AlonSpinner/GarageDoor_with4Bar/Documentation/7Min.pptx

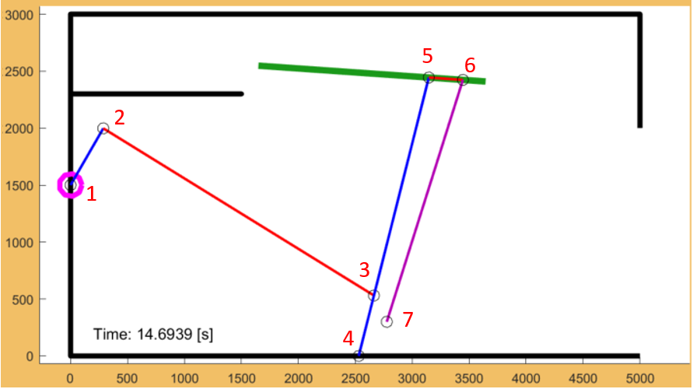
[picture p4: figure]
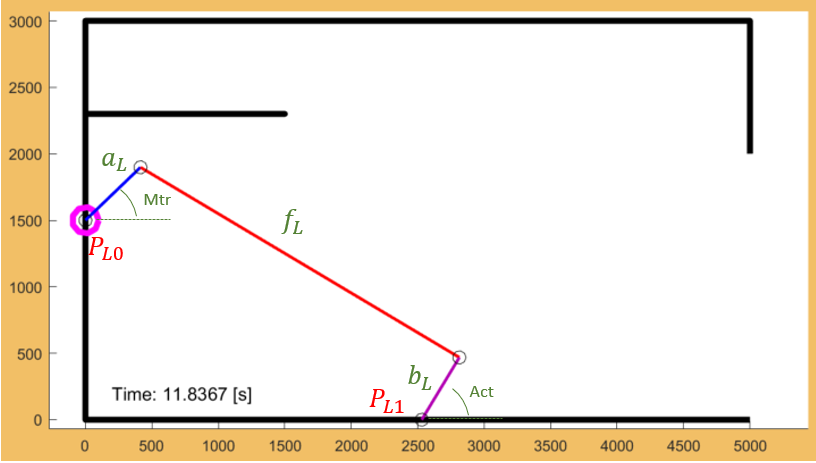
[picture p5: figure]
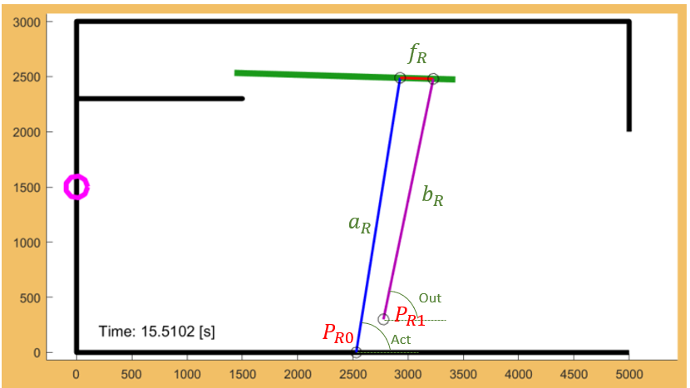
[picture p6: figure]

## Slide 2

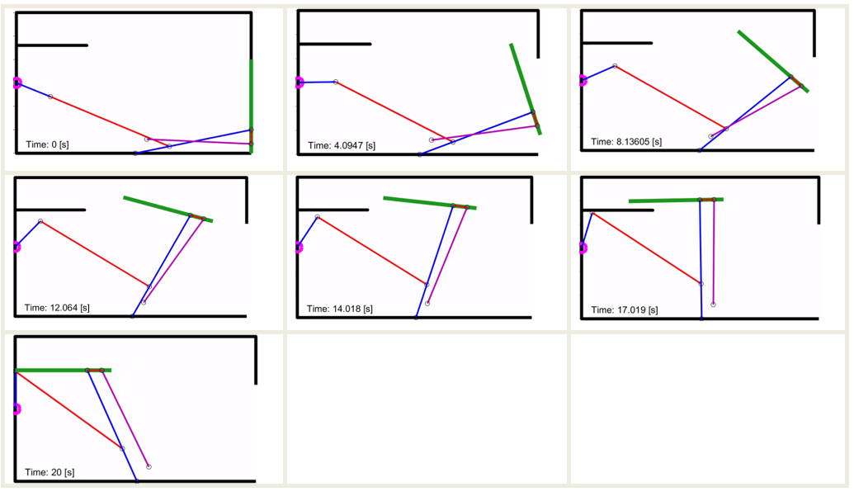
[picture p7: figure]

## Slide 3

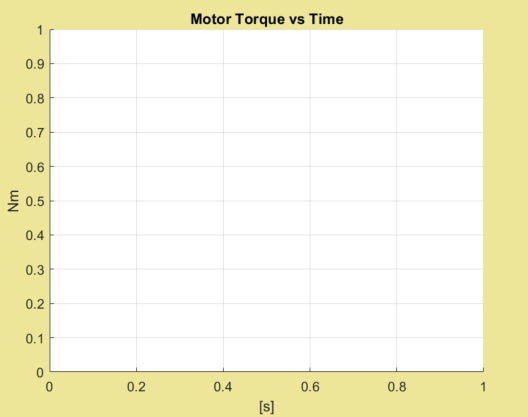
[picture p8: figure]

## Slide 4

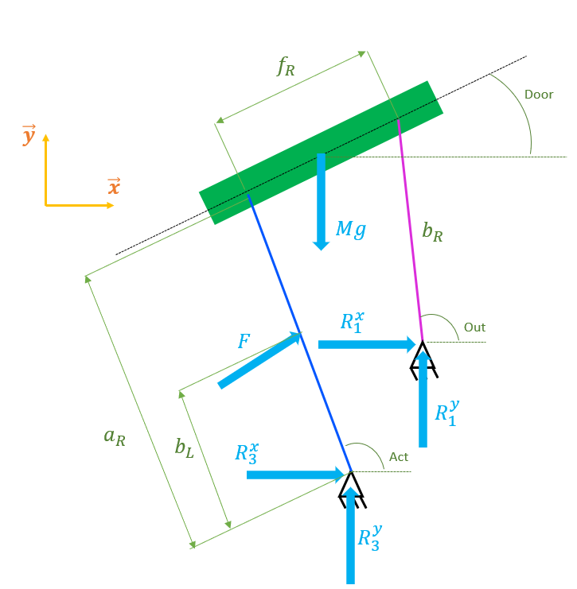
[picture p9: figure]
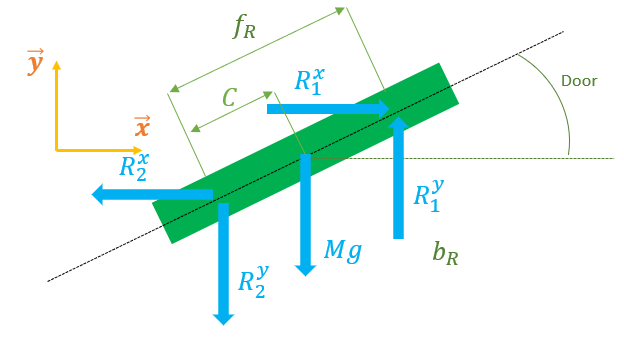
[picture p10: figure]
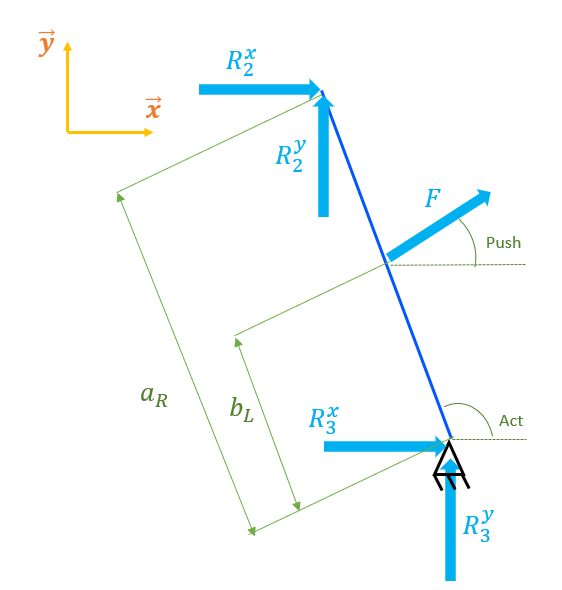
[picture p11: figure]
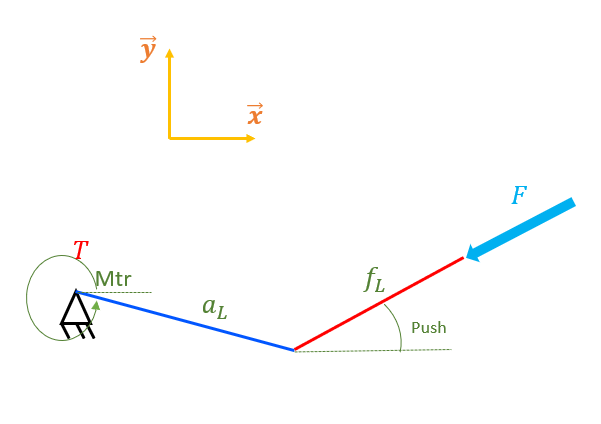
[picture p12: figure]

## Slide 5

סינטזה מכניזם שמאל
Freundestein

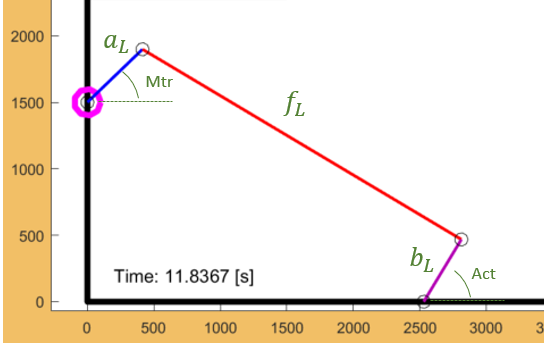
[picture p13: figure]

סינטזה מכניזם ימין
2 נק' דיוק לכל ציר

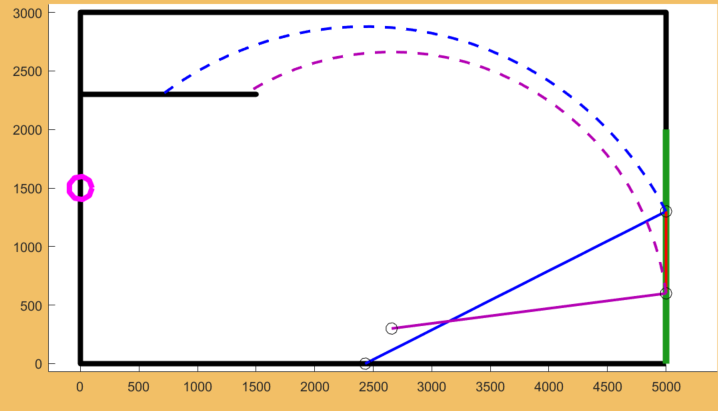
[picture p14: figure]
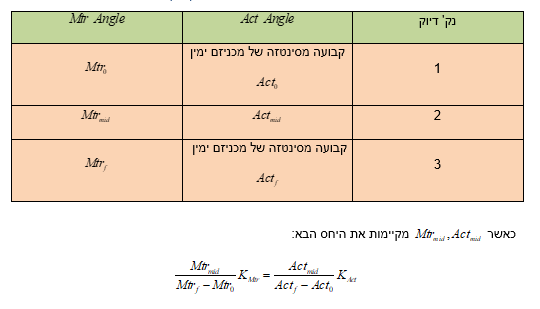
[picture p15: figure]
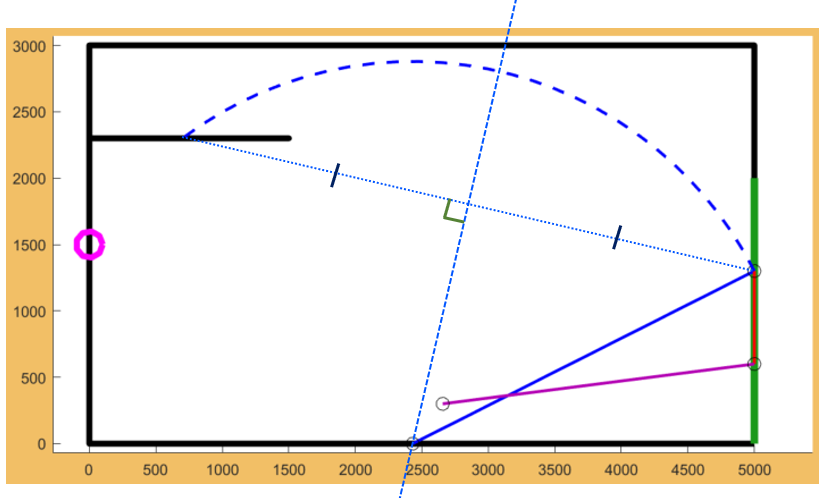
[picture p16: figure]

## Slide 6

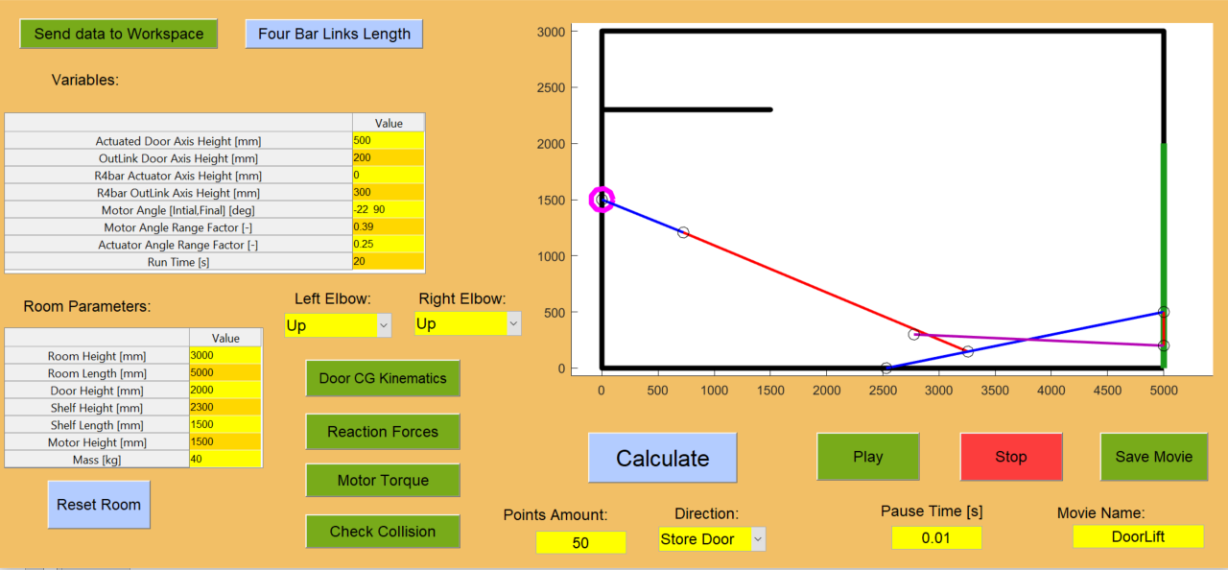
[picture p17: figure]

## Slide 7

נכנסו במדף. מנסים להוריד את הסמכים במנגנון ימין

כבר ממש טוב. אבל אפשר להוריד את הצירים של הדלת עוד.

טריקה של דלת
בסוף מסלול.
מנסים לקצר זרוע מניעה

מגדילים טווח זוויות ע"י שינוי כיוון

מומנטים גבוהים מידי נובעים מטריקה של דלת בסוף מסלול. עוברים לזוויות צד שני

מתרחקים מהנק' המתה. מקטינים ריאקציות, ומגדילים קצת מומנט, כדי להגיע לנק' המושלמת. מתחת ל-2500N רדיאלי

כיוון טוב. מנסים לשפר ע"י הורדה של הגובה בצירים של הדלת

## Slide 8

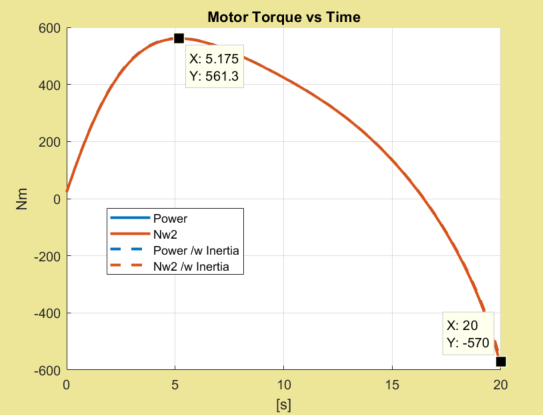
[picture p18: figure]
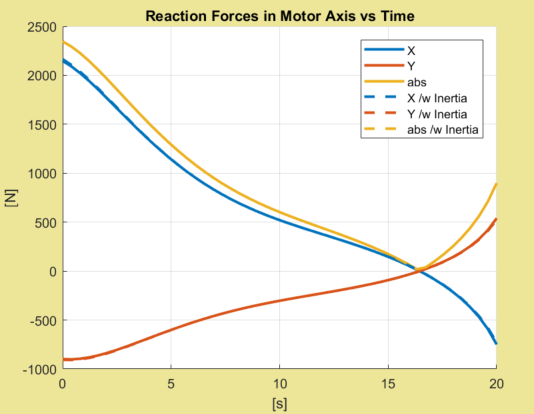
[picture p19: figure]

## Slide 9

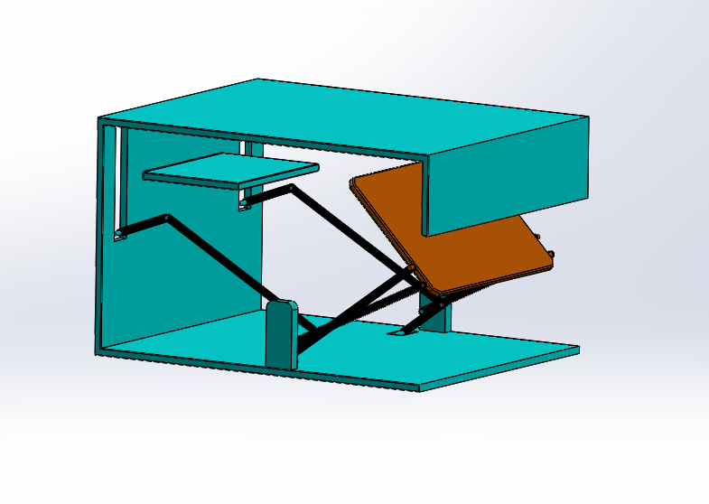
[picture p20: figure]
