AlonSpinner/GarageDoor_with4Bar/Documentation/Images.pptx

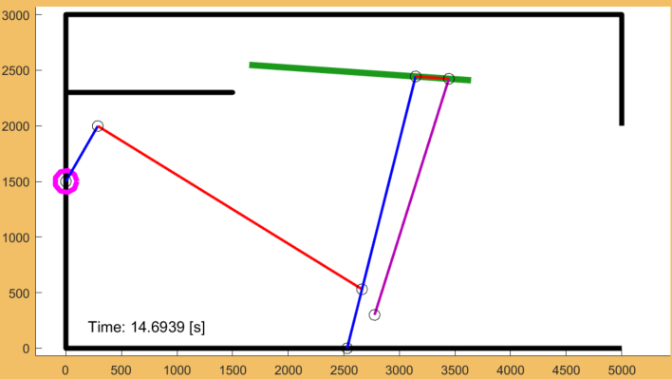
[picture p21: figure]

5

6

2

1

3

4

7

## Slide 2

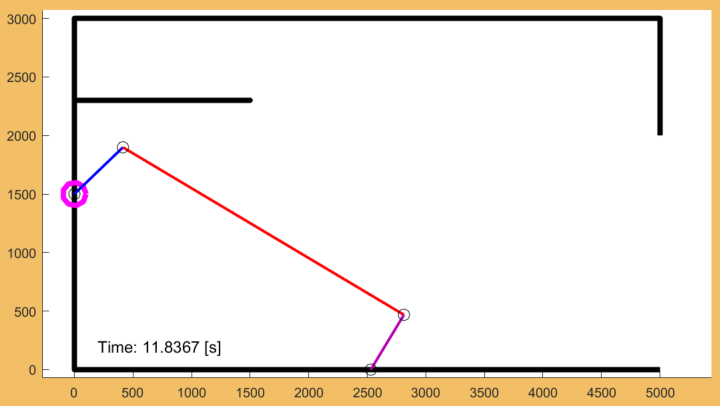
[picture p22: figure]

a_L

P_(L0)

Mtr

f_L

P_(L1)

Act

b_L

## Slide 3

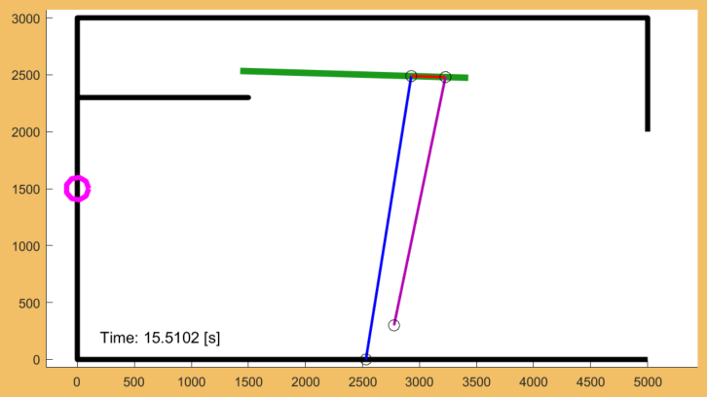
[picture p23: figure]

f_R

Actuator

b_R

a_R

Out

Act

P_(R1)

P_(R0)

## Slide 4


## Slide 5

## Slide 6

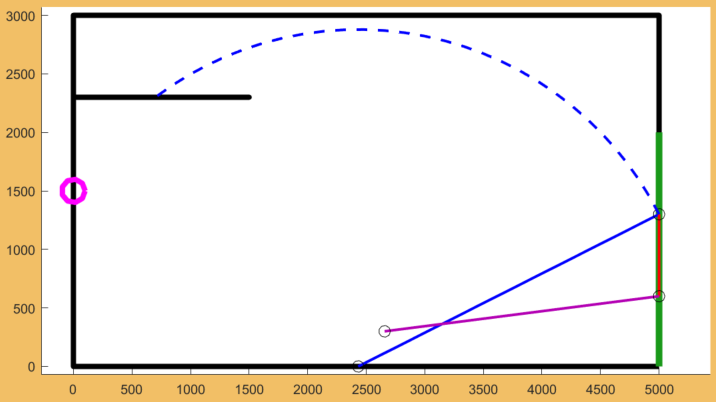
[picture p24: figure]

## Slide 7

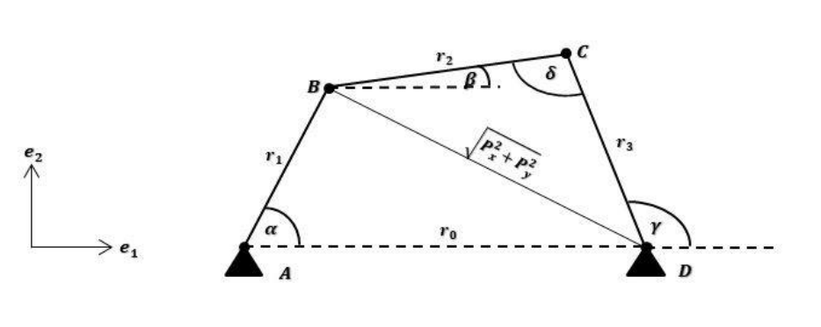
[picture p25: figure]

f

a

b

g

## Slide 8

f

a

e

b

g

## Slide 9

E_2

H_(door)

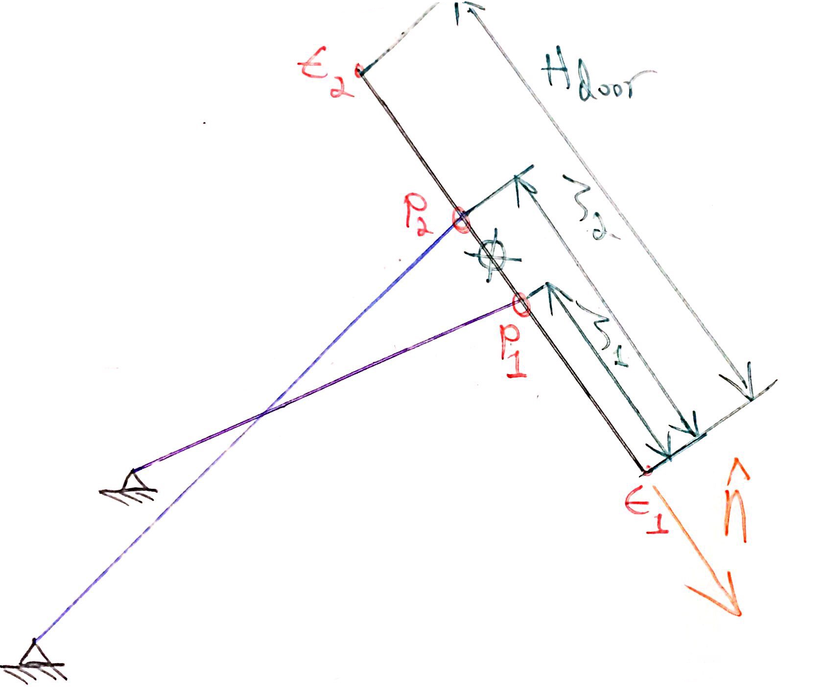
[picture p26: figure]

P_2

ξ_2

ξ_1

P_1

E_1

n

## Slide 10

θ

r

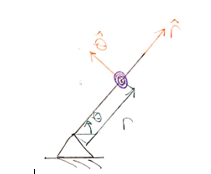
[picture p27: figure]

r

θ

## Slide 11

a

H_(door)

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
## Slide 12

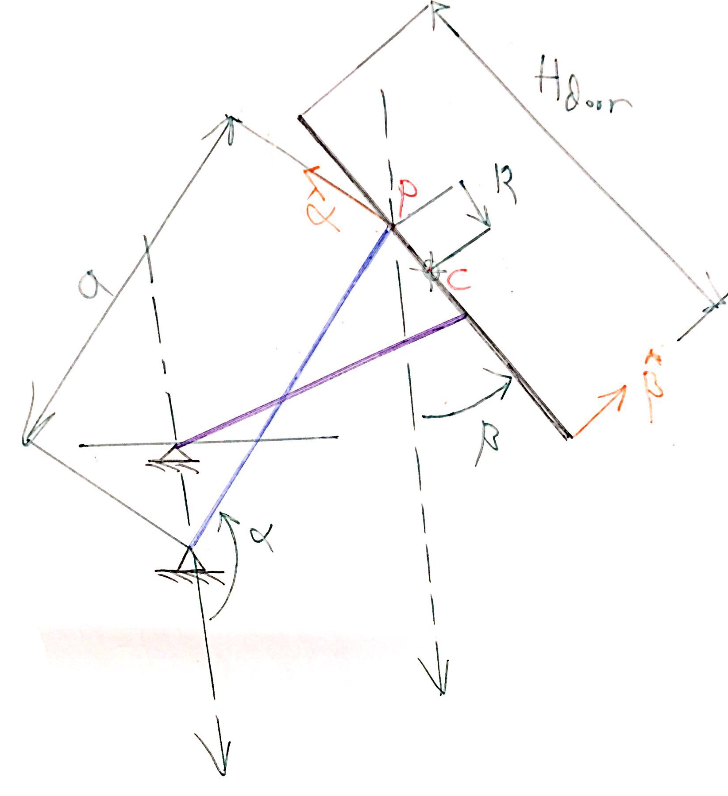
[picture p28: figure]

H_(door)

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
## Slide 13

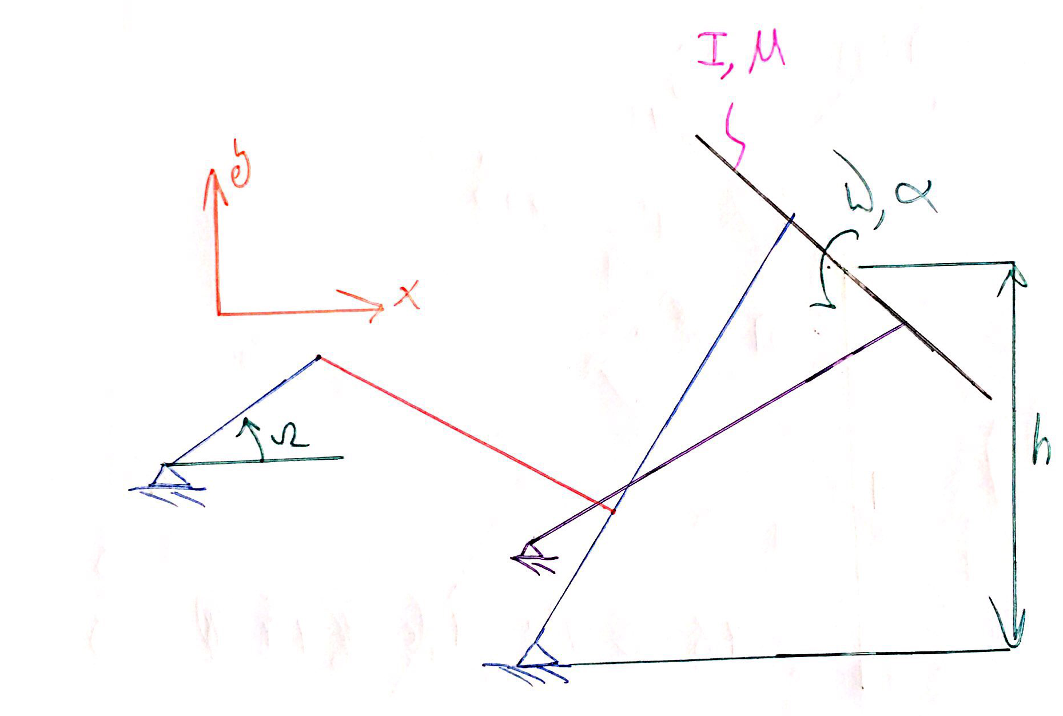
[picture p29: figure]

y

x

I,M

α, ω

Ω

h

β

## Slide 14

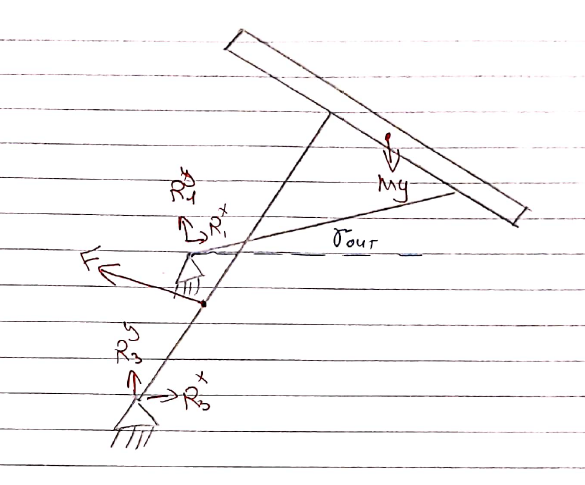
[picture p30: figure]

f_R

Door

y

x

Mg

b_R

F

R_1^x

Out

a_R

b_L

R_3^x

Act

R_1^y

R_3^y

## Slide 15

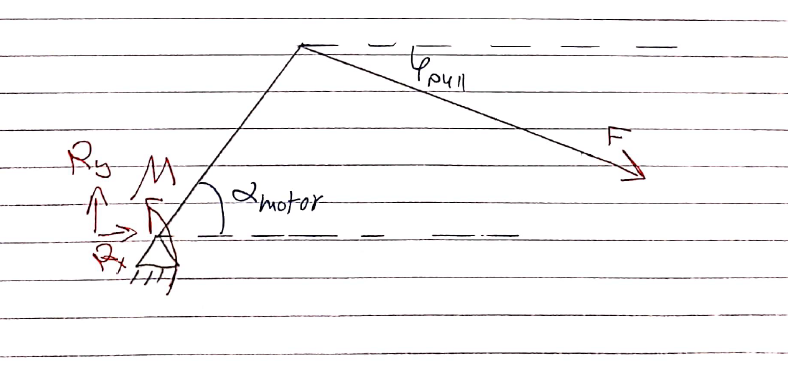
[picture p31: figure]

y

x

F

Mtr

T

Push

f_L

a_L

## Slide 16

f_R

y

C

R_1^x

Door

R_2^x

x

R_1^y

R_2^y

Mg

b_R

## Slide 17

y

R_2^x

x

R_2^y

Push

F

a_R

b_L

R_3^x

Act

R_3^y

## Slide 18

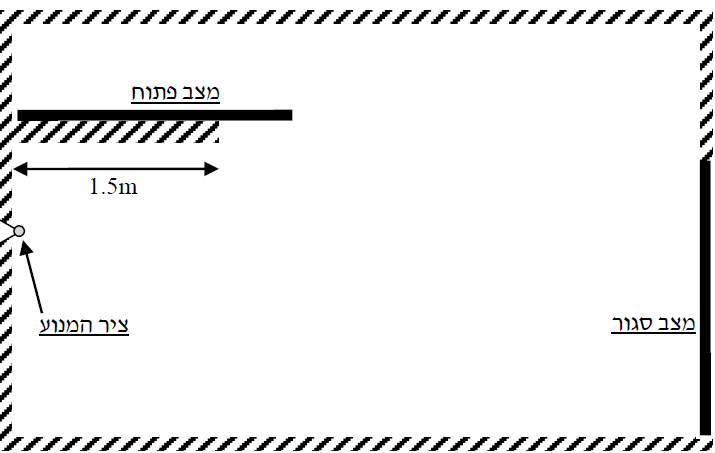
[picture p32: figure]
