AlonSpinner/GarageDoor_with4Bar/Solidworks/Room assembly.SLDASM

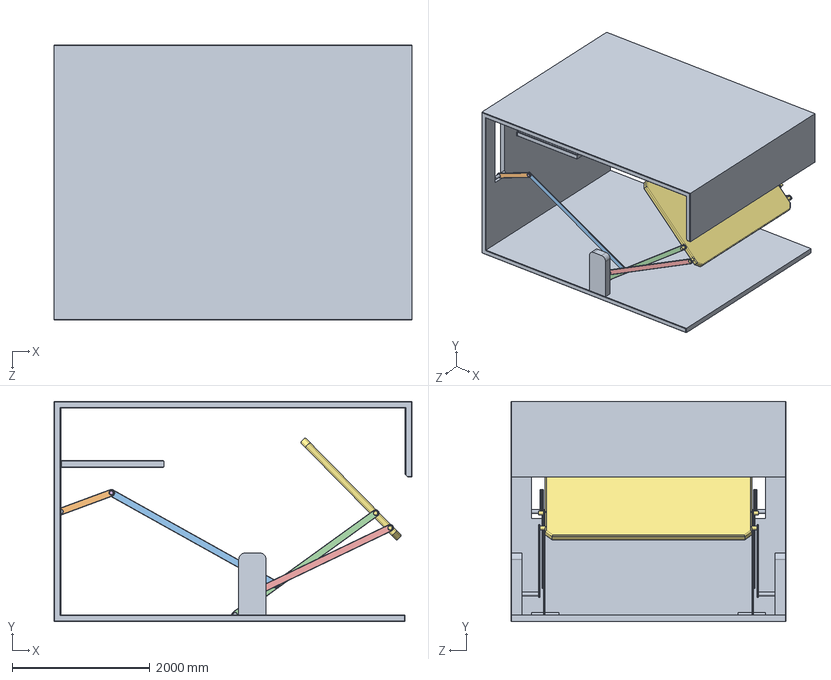
[picture p58: CAD file, 2021-06-20]
Solidworks/Room assembly.SLDASM
5200.0 x 3200.0 x 4000.0 mm
frame
motor a link x 2
motor f link x 2
actoator a link x 2
actoator b link x 2
pin x 4
door
