AlonSpinner/GarageDoor_with4Bar/Solidworks/actoator a link.SLDPRT

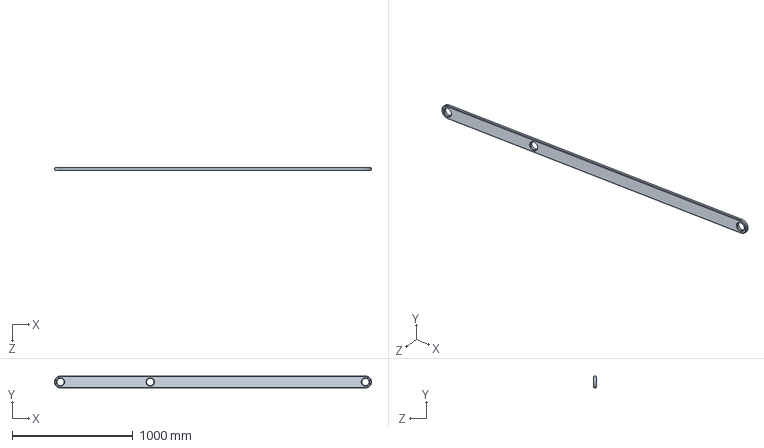
[picture p59: CAD file, 2021-06-20]
Solidworks/actoator a link.SLDPRT
2620.0 x 100.0 x 25.0 mm
