AlonSpinner/GarageDoor_with4Bar/Solidworks/actoator b link.SLDPRT

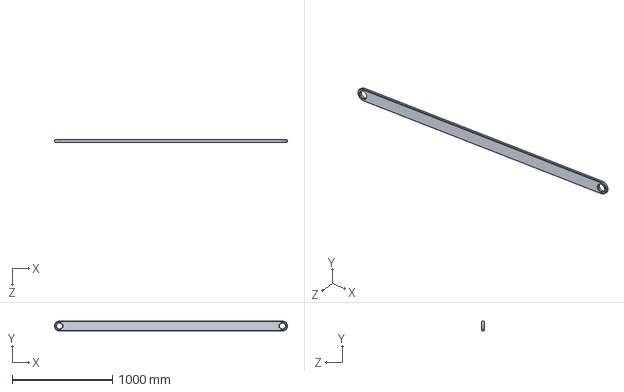
[picture p60: CAD file, 2021-06-20]
Solidworks/actoator b link.SLDPRT
2325.0 x 100.0 x 25.0 mm
