AlonSpinner/GarageDoor_with4Bar/Solidworks/frame.SLDPRT

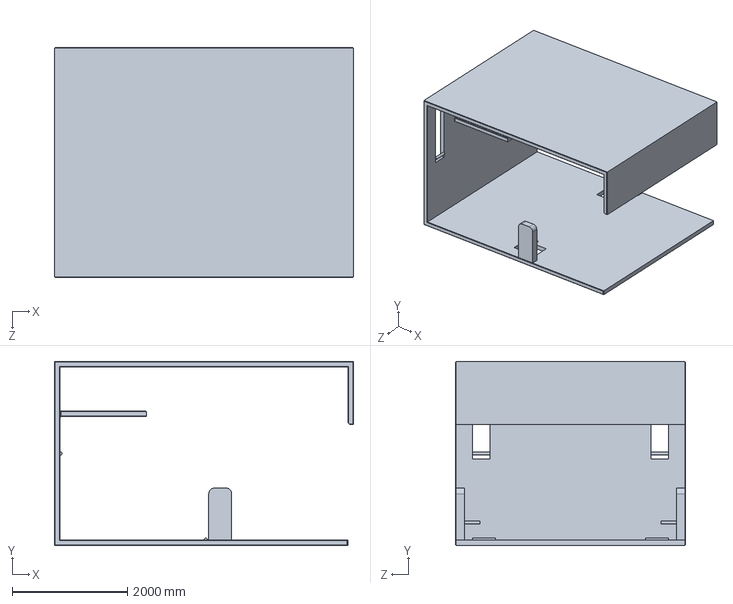
[picture p61: CAD file, 2021-06-20]
Solidworks/frame.SLDPRT
5200.0 x 3200.0 x 4000.0 mm
