AlonSpinner/GarageDoor_with4Bar/Solidworks/general link.SLDPRT

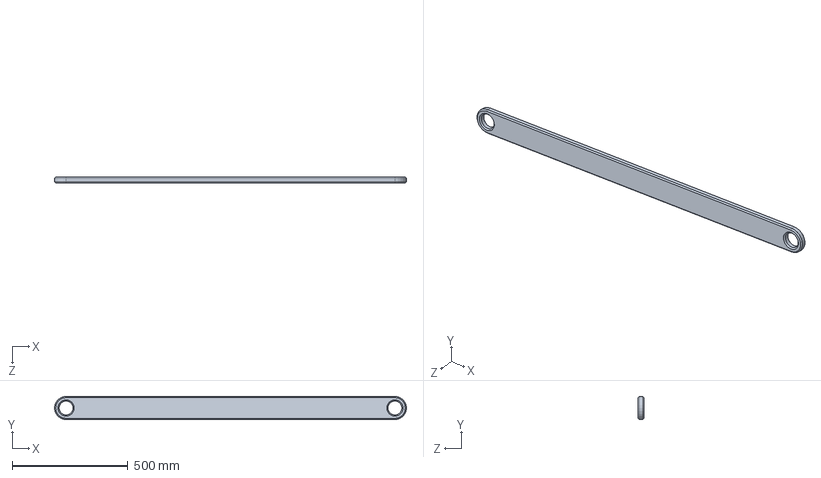
[picture p62: CAD file, 2021-06-20]
Solidworks/general link.SLDPRT
1520.0 x 100.0 x 25.0 mm
