AlonSpinner/GarageDoor_with4Bar/Solidworks/test.SLDPRT

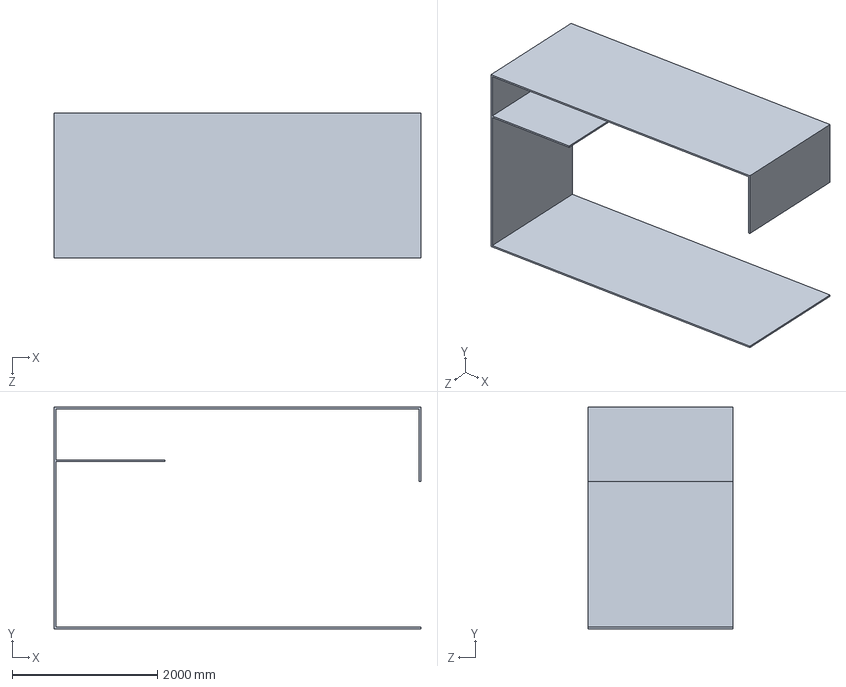
[picture p63: CAD file, 2021-06-20]
Solidworks/test.SLDPRT
5050.0 x 3050.0 x 2000.0 mm
