AlonSpinner/GarageDoor_with4Bar/Solidworks/motor b link.SLDPRT

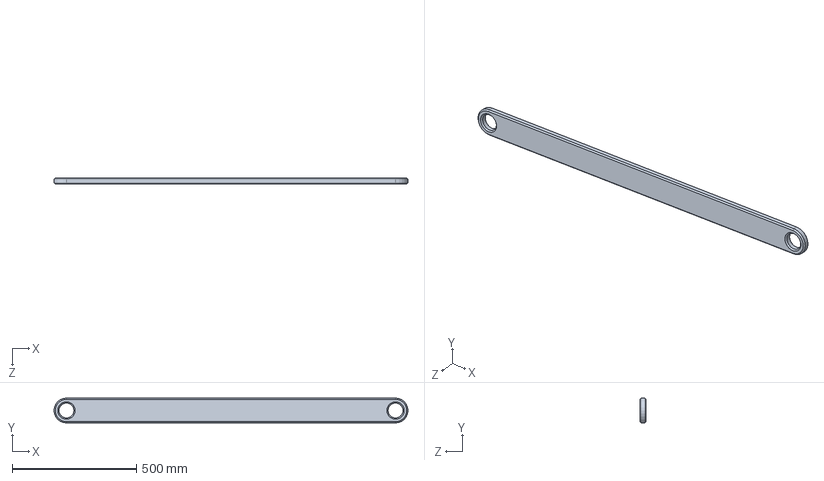
[picture p64: CAD file, 2021-06-20]
Solidworks/motor b link.SLDPRT
1425.0 x 100.0 x 25.0 mm
