AlonSpinner/GarageDoor_with4Bar/Solidworks/pin.SLDPRT

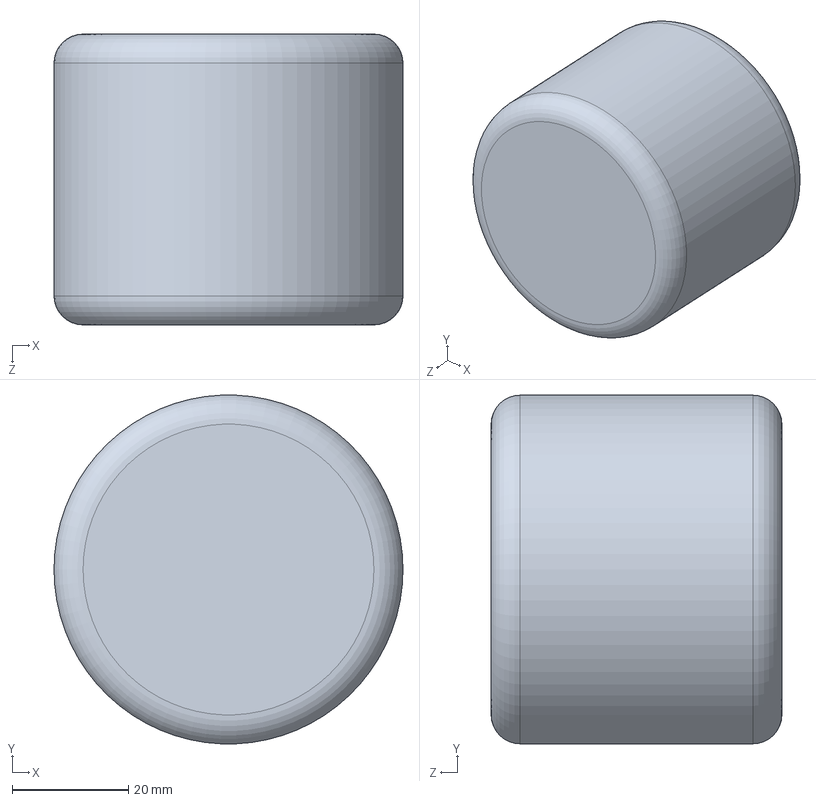
[picture p65: CAD file, 2021-06-20]
Solidworks/pin.SLDPRT
60.0 x 59.9 x 50.0 mm
