AlonSpinner/GarageDoor_with4Bar/Solidworks/motor f link.SLDPRT

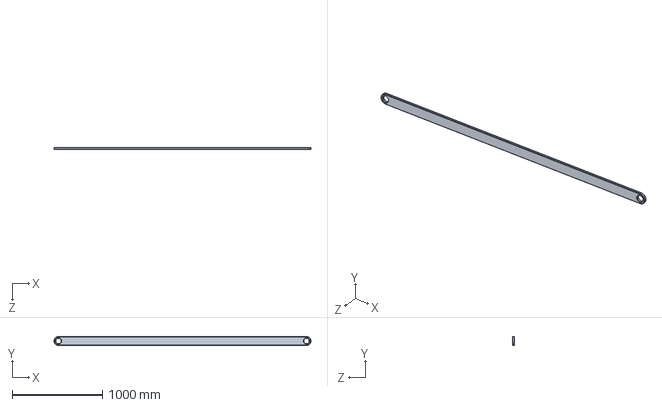
[picture p66: CAD file, 2021-06-20]
Solidworks/motor f link.SLDPRT
2845.0 x 100.0 x 25.0 mm
