AlonSpinner/GarageDoor_with4Bar/Solidworks/motor a2 link.SLDPRT

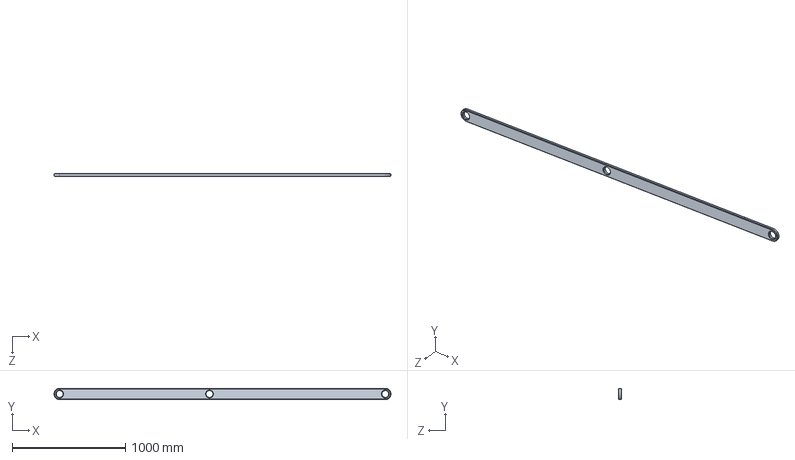
[picture p67: CAD file, 2021-06-20]
Solidworks/motor a2 link.SLDPRT
2980.0 x 100.0 x 25.0 mm
