AlonSpinner/GarageDoor_with4Bar/Solidworks/door.SLDPRT

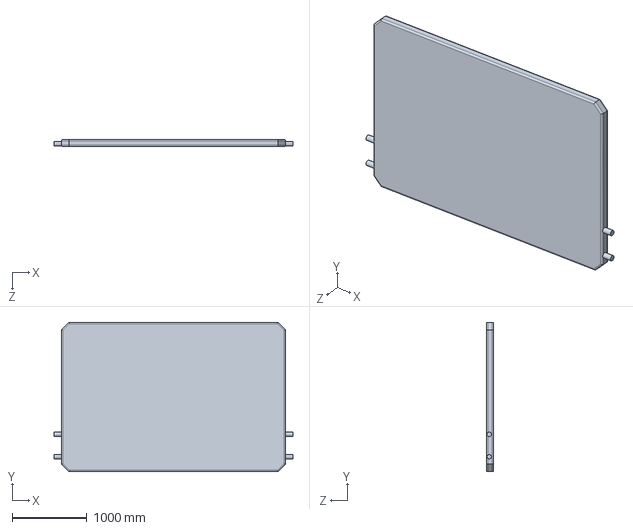
[picture p68: CAD file, 2021-06-20]
Solidworks/door.SLDPRT
3200.0 x 2000.0 x 100.0 mm
