AlonSpinner/GarageDoor_with4Bar/Solidworks/motor a link.SLDPRT

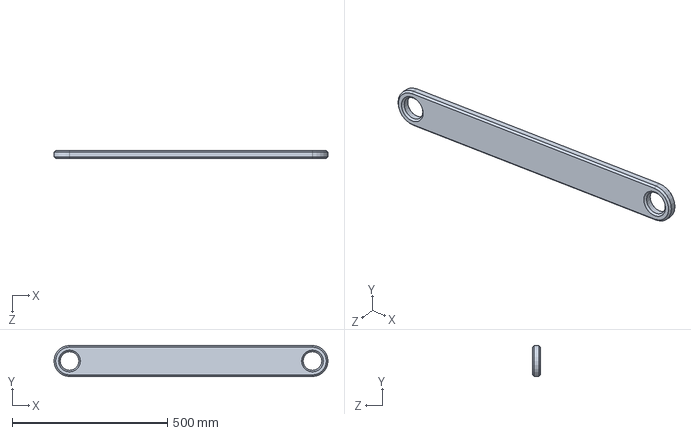
[picture p69: CAD file, 2021-06-20]
Solidworks/motor a link.SLDPRT
881.8 x 100.0 x 25.0 mm
