AlonSpinner/GarageDoor_with4Bar/(list of files, cad)

Other CAD files:
Solidworks/Project.SLDPRT
